the-simsons/ego2sim-sensors-motors/main/README.md

Make sure to install Arduino library: "Qwiic Distance Sensor (VL53L1X)"
https://learn.sparkfun.com/tutorials/qwiic-distance-sensor-vl53l1x-hookup-guide/arduino-library-overview
