the-simsons/ego2sim-sensors-motors/gui/ego2sim-panel/README.md

# Ego2Sim Control panel

Foxglove extension panel for the Ego2Sim sensors and motors lab. See [../README.md](../README.md) for setup and usage.
