the-simsons/ego2sim-sensors-motors/flex_sensor_TF.png

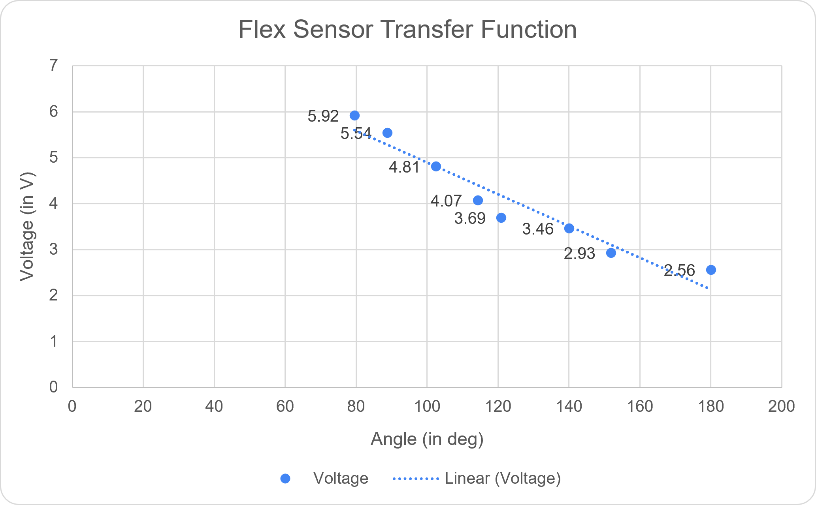
flex_sensor_TF.png
