the-simsons/ego2sim-sensors-motors/transferfunctionwithresistance.png

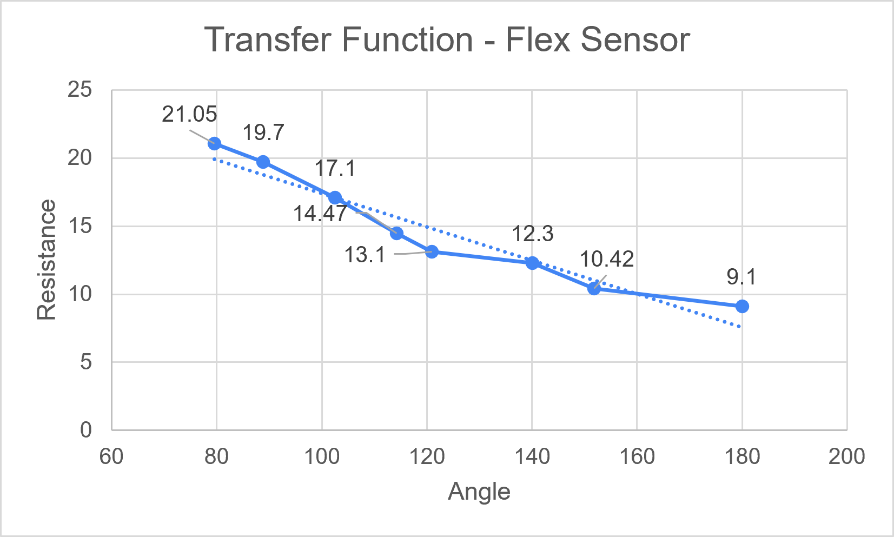
transferfunctionwithresistance.png
