the-simsons/ego2sim-sensors-motors/(commit log)

2026-11-09 + Added TOF distance sensor to arduino code
2026-11-09 + Add IR distance sensor
2026-11-10 working stepper code
2026-11-10 motor code done- stepper+servo tested, dc not tested
2026-11-11 feat(gui): add Foxglove control panel, layout and mock backend
    - Ego2Sim Control panel (Foxglove extension): sensor readouts in physical
    units, motor state, GUI/SENSOR mode toggle, servo/DC/stepper commands,
    STOP, command ACK tracking and diagnostics
    - Layout with raw-vs-filtered plots for IR and flex
    - Mock backend over Foxglove WebSocket for testing without ROS 2 or the Uno
    - Flex sensor topics replace FSR topics from interface contract v2.0
2026-11-11 Add ROS 2 Humble sensor and motor backend
    - Add custom interfaces, serial bridge, and sensor processing
    - Match GUI flex topics with ScalarStamped angle messages
    - Add calibration, filtering, diagnostics, and mock transport
    - Add hardware/mock launches and source workspace before Foxglove
    - Document serial protocol for teammate-owned firmware integration
    - Add tests for parsing, command handling, reconnects, and mock behavior
    Validation: 15 tests passed; ROS integration skipped without Humble.
    Hardware motor execution remains pending firmware integration.
    [Arduino.h, processing.py, protocol.py]
2026-11-11 all motors working, dc tuned
2026-11-11 Create temt6000.ino
    Added Ambient Light sensor code
2026-11-11 Create maxsonar_pwm.ino
    Add MaxSonar EZ PW reading on pin 6.
2026-11-12 Merge sensor and motor sketches into one firmware
    Combine main.ino (flex, Sharp IR, VL53L1X), temt6000.ino (ambient light +
    filter), maxsonar_pwm.ino and motor_test.ino into a single non-blocking
    sketch for the Uno:
    - Sensors converted to physical units; flex, light and IR also report a
    moving-average + EMA filtered value.
    - Servo, 1/8-microstep stepper and encoder DC motor (tuned PID kept).
    - Debounced pushbutton on A3 toggles GUI/SENSOR mode; sensor mapping
    matches the GUI mock (flex->servo, IR->DC, ToF->stepper).
    - MaxSonar read via pin-change interrupt on D10 (D6 is the stepper EN pin).
    - Queued serial output so printing ne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
    [main.ino, temt6000.ino]
2026-11-12 + Update ROS2 layer to handle latest arduino code
2026-11-13 Transfer function (Flex Sensor)
2026-11-13 Transfer function with resistance
